UNIT-Electronics-MX/unit_pulsar_rp2350a/tools/product-reference/chapters/08-references.md

## **8 Reference Documentation**

The following resources provide the official hardware, software, and application documentation for the UNIT PULSAR RP2350A.

| Reference | Location |
|---|---|
| Product repository | [UNIT-Electronics-MX/unit_pulsar_rp2350a](https://github.com/UNIT-Electronics-MX/unit_pulsar_rp2350a) |
| Hardware reference | [hardware/README.md](https://github.com/UNIT-Electronics-MX/unit_pulsar_rp2350a/blob/main/hardware/README.md) |
| Technical wiki | [PULSAR RP2350A Wiki](https://github.com/UNIT-Electronics-MX/unit_pulsar_rp2350a/wiki) |
| Getting Started | [Setup guide](https://github.com/UNIT-Electronics-MX/unit_pulsar_rp2350a/wiki/0-Getting-Started) |
| C++ examples | [software/cpp_examples](https://github.com/UNIT-Electronics-MX/unit_pulsar_rp2350a/tree/main/software/cpp_examples) |
| Board schematic | [Hardware V1.3.0 schematic](https://github.com/UNIT-Electronics-MX/unit_pulsar_rp2350a/blob/main/hardware/unit_sch_v_1_3_0_pulsar_rp2350a.pdf) |
| RP2350 component datasheet | [Raspberry Pi RP2350 Datasheet](https://datasheets.raspberrypi.com/rp2350/rp2350-datasheet.pdf) |

The UNIT Electronics Wiki provides application-oriented documentation, setup procedures, peripheral usage examples, and software workflows for the board.

The hardware schematic and this Product Reference define the board-level implementation, connections, power architecture, interfaces, and hardware characteristics. RP2350A device-level electrical characteristics and processor specifications should be referenced from the official Raspberry Pi RP2350 datasheet.
