UNIT-Electronics-MX/unit_pulsar_rp2350a/tools/product-reference/chapters/00-description.md

## **Description**

The UNIT PULSAR RP2350 is a multi-interface development board in the UNIT
DevLab ecosystem, built around the Raspberry Pi RP2350A microcontroller. The V1.3 design
combines external QSPI flash and PSRAM with motion sensing, PDM audio, microSD,
USB-C, battery support, addressable RGB indicators, QWIIC I2C, and a 22-pin
HSTX expansion connector.



### **Applications**

- RP2350 firmware and peripheral prototyping
- Motion and PDM audio acquisition
- microSD data logging
- HSTX graphics experiments
- External-memory and multicore applications
- Education and subsystem validation

### **Hardware Features**

- RP2350A microcontroller with external W25Q128 128 Mbit QSPI flash
- APS6404L-3SQR-ZR 8 MiB PSRAM
- BMI270 six-axis inertial measurement unit
- ICS-41350 digital PDM microphone
- Four-bit SDIO microSD connection
- Three WS2812-compatible RGB LEDs plus power, charge, and user indicators
- USB-C, QWIIC, battery, edge-pad, SWD, and HSTX connections
