UNIT-Electronics-MX/unit_pulsar_rp2350a/tools/product-reference/chapters/01-board.md

## **1 The Board**

The UNIT PULSAR RP2350 is a development board for evaluating the
Raspberry Pi RP2350A and building applications that combine high-speed digital
output, removable storage, motion sensing, digital audio, external memory, and
general-purpose I/O. Hardware revision V1.3.0 places the controller, QSPI flash,
PSRAM, power components, indicators, and user controls on the top side. The
microSD socket, battery connection, onboard microphone, debug pads, and HSTX
connector are accessible from the bottom side.

### **1.1 Accessories** {.section-page}

The following optional accessories are recommended for use with the UNIT PULSAR RP2350A. Select accessories according to the interfaces and features required by the application.

| Accessory | Purpose | Selection notes |
|---|---|---|
| [QWIIC cable](https://uelectronics.com/producto/arnes-qwiic-4-pines-pitch-1mm/) | External I2C expansion | 4-pin, 1 mm pitch cable for connecting compatible 3.3 V QWIIC devices |
| USB-C data cable | Power, programming, and USB serial | Must support data; a charge-only cable cannot upload firmware |
| [MicroSD card](https://uelectronics.com/producto/memoria-micro-sd-kingston-16-64-gb-clase-10/) | Removable storage and data logging | Class 10 microSD card; FAT32 formatting is recommended for the provided examples |
| [UNIT DevLab DVI to FPC Adapter](https://uelectronics.com/producto/adaptador-dvi-a-fpc-unit-devlab/) | HSTX DVI-compatible video output | Recommended adapter for using the board's HSTX video interface through the 22-pin FPC connector |
| 22-pin FPC cable | Connection between the HSTX connector and DVI adapter | 22-position, 0.5 mm pitch; planned for future availability from UNIT Electronics |
| [LiPo 3.7 V 650 mAh Battery](https://uelectronics.com/producto/bateria-lipo-3-7v-650mah-802535/) | Battery-powered operation | Recommended single-cell LiPo battery; verify polarity and connector orientation before connection |

Verify connector type, orientation, polarity, voltage domain, and pinout before connecting accessories.

### **1.2 Board Identification**

| Item | Value |
|---|---|
| Product | UNIT PULSAR RP2350 |
| Product family | UNIT DevLab ecosystem |
| Product type | Multi-interface RP2350A development board |
| Main component | Raspberry Pi RP2350A, QFN-60 |
| Hardware revision | V1.3.0 |
| Product Reference | Version 0.1.0 |
| Primary programming interface | USB-C / RP2350 USB boot workflow |
| Debug interface | SWD pads on bottom side |

Hardware revision and documentation revision are identified independently.

### **1.3 Main Assemblies**

| RefDes | Component | Function |
|---|---|---|
| IC3 | RP2350A | Main processor and peripheral controller |
| IC1 | W25Q128JVPIQ | 128 Mbit (16 MiB) external QSPI flash |
| IC4 | APS6404L-3SQR-ZR | 8 MiB external PSRAM |
| IC5 | BMI270 | Six-axis accelerometer and gyroscope |
| MK1 | ICS-41350 | Digital PDM microphone |
| U1 | AP2112K-3.3TRG1 | Fixed 3.3 V LDO |
| IC2 | MCP73831T-2ACI/OT | Single-cell Li-Ion/Li-Polymer charge controller |
| XTAL1 | XOS20012000LT00351005 | 12 MHz reference oscillator |
| MICRO_SD-HOLDER | 47309-2651 | Removable microSD storage |
| LED1–LED3 | WS2812 1010 | Cascaded addressable RGB indicators |
| J1 | HCZZ0032-4 | Four-position QWIIC-style I2C connector |
| J5 | FH34SRJ-22S-0.5SH(50) | 22-position HSTX FFC/FPC connector |
| JP1 | PH2.0 2P | Two-position battery connection |

### **1.4 Board Views** {.section-page}



The top view identifies the USB-C connector, BOOT and reset controls, edge-pad
labels, RP2350A, flash, PSRAM, QWIIC connector, oscillator, and three RGB LEDs.



The bottom view identifies the battery polarity marks, microSD socket, microphone acoustic port, SWD pads, HSTX connector, and V1.3.0 revision marking.

### **1.5 Handling** {.section-page}

Handle the board using normal ESD precautions. Avoid touching the microphone
port, connector contacts, or exposed test pads. Remove power before inserting
or removing FFC/FPC and battery connectors. Keep conductive objects away from
the bottom-side battery and microSD areas when the board is energized.
