UNIT-Electronics-MX/unit_pulsar_rp2350a/docs/hardware/index.html

UNIT Electronics · DevLab

# UNIT PULSAR RP2350 SENSE

Direct links to hardware documentation and product files for use in external platforms.

42 files 31 images 6 formats 57.2 MB total

Search hardware resources

## Product documents

6 files

DOCX 3.6 MB

### Product Reference

Editable product reference

unit_product_reference_v_0_1_0_pulsar_rp2350a.docx

Copy link Open file

PDF 3.9 MB

### Product Reference

Publication-ready product reference

unit_product_reference_v_0_1_0_pulsar_rp2350a.pdf

Copy link Open file

PDF 248.5 KB

### Schematic

Electrical schematic

unit_sch_v_1_3_0_pulsar_rp2350a.pdf

Copy link Open file

PNG 536.8 KB

### Schematic

Electrical schematic

resources/unit_schematic_v_1_3_0_pulsar_rp2350a_sheet_1.png

Copy link Open file

PNG 176.1 KB

### Schematic

Electrical schematic

resources/unit_schematic_v_1_3_0_pulsar_rp2350a_sheet_2.png

Copy link Open file

PNG 84.6 KB

### Schematic

Electrical schematic

resources/unit_schematic_v_1_3_0_pulsar_rp2350a_sheet_3.png

Copy link Open file

## Pinouts

12 files

PDF 1.5 MB

### Pinout — English

Connector and signal reference in English

unit_bottom_pinout_v1_3_0_ue0103_pulsar_rp2350a_en.pdf

Copy link Open file

PDF 3.2 MB

### Pinout — English

Connector and signal reference in English

unit_pinout_v1_3_0_ue0103_pulsar_rp2350a_en.pdf

Copy link Open file

PDF 1.9 MB

### Pinout — English

Connector and signal reference in English

unit_top_pinout_v1_3_0_ue0103_pulsar_rp2350a_en.pdf

Copy link Open file

PNG 1.8 MB

### Pinout — English

Connector and signal reference in English

resources/unit_bottom_pinout_v1_3_0_ue0103_pulsar_rp2350a_en.png

Copy link Open file

PNG 3.8 MB

### Pinout — English

Connector and signal reference in English

resources/unit_pinout_v1_3_0_ue0103_pulsar_rp2350a_en.png

Copy link Open file

PNG 2.2 MB

### Pinout — English

Connector and signal reference in English

resources/unit_top_pinout_v1_3_0_ue0103_pulsar_rp2350a_en.png

Copy link Open file

PDF 1.5 MB

### Pinout — Spanish

Connector and signal reference in Spanish

unit_bottom_pinout_v1_3_0_ue0103_pulsar_rp2350a_es.pdf

Copy link Open file

PDF 3.2 MB

### Pinout — Spanish

Connector and signal reference in Spanish

unit_pinout_v1_3_0_ue0103_pulsar_rp2350a_es.pdf

Copy link Open file

PDF 1.9 MB

### Pinout — Spanish

Connector and signal reference in Spanish

unit_top_pinout_v1_3_0_ue0103_pulsar_rp2350a_es.pdf

Copy link Open file

PNG 1.8 MB

### Pinout — Spanish

Connector and signal reference in Spanish

resources/unit_bottom_pinout_v1_3_0_ue0103_pulsar_rp2350a_es.png

Copy link Open file

PNG 3.8 MB

### Pinout — Spanish

Connector and signal reference in Spanish

resources/unit_pinout_v1_3_0_ue0103_pulsar_rp2350a_es.png

Copy link Open file

PNG 2.2 MB

### Pinout — Spanish

Connector and signal reference in Spanish

resources/unit_top_pinout_v1_3_0_ue0103_pulsar_rp2350a_es.png

Copy link Open file

## Board views

5 files

JPG 4.5 MB

### Board Topology

Functional board layout

resources/unit_topology_v1_3_0_ue0103_pulsar_rp2350a.jpg

Copy link Open file

PNG 2.7 MB

### Board Topology

Functional board layout

resources/unit_topology_v1_3_0_ue0103_pulsar_rp2350a.png

Copy link Open file

PNG 85.9 KB

### Bottom View

Bottom-side board view

resources/unit_btm_v_1_3_0_pulsar_rp2350a.png

Copy link Open file

PNG 1.9 MB

### Mechanical Dimensions

Board outline and dimensions

resources/unit_dimensions_v1_3_0_ue0103_pulsar_rp2350a.png

Copy link Open file

PNG 111.8 KB

### Top View

Top-side board view

resources/unit_top_v_1_3_0_pulsar_rp2350a.png

Copy link Open file

## Other resources

19 files

MD 7.2 KB

### Hardware README

Hardware overview and source notes

README.md

Copy link Open file

PDF 7.6 MB

### Rp2350 Datasheet

Hardware resource

rp2350-datasheet.pdf

Copy link Open file

PNG 251.0 KB

### Unit Block Diagram V 1 3 0 Pulsar Rp2350A

Hardware resource

resources/unit_block_diagram_v_1_3_0_pulsar_rp2350a.png

Copy link Open file

SVG 3.7 KB

### Unit Block Diagram V 1 3 0 Pulsar Rp2350A

Hardware resource

resources/unit_block_diagram_v_1_3_0_pulsar_rp2350a.svg

Copy link Open file

JPG 385.4 KB

### Unit Block V 1 0 0 Ue0103 Pulsar Rp2350A

Hardware resource

resources/unit_block_v_1_0_0_ue0103_pulsar_rp2350a.jpg

Copy link Open file

JPG 255.1 KB

### Unit Power Tree V 1 0 0 Ue0103 Pulsar Rp2350A

Hardware resource

resources/unit_power_tree_v_1_0_0_ue0103_pulsar_rp2350a.jpg

Copy link Open file

PNG 189.4 KB

### Unit Power Tree V 1 3 0 Pulsar Rp2350A

Hardware resource

resources/unit_power_tree_v_1_3_0_pulsar_rp2350a.png

Copy link Open file

SVG 3.0 KB

### Unit Power Tree V 1 3 0 Pulsar Rp2350A

Hardware resource

resources/unit_power_tree_v_1_3_0_pulsar_rp2350a.svg

Copy link Open file

JPG 91.8 KB

### Unit Rp2350A Qfn60 Package Pulsar Rp2350

Hardware resource

resources/unit_rp2350a_qfn60_package_pulsar_rp2350.jpg

Copy link Open file

JPG 146.2 KB

### Unit Wiki Battery Rp2350

Hardware resource

resources/unit_wiki_battery_rp2350.jpg

Copy link Open file

PNG 257.2 KB

### Unit Wiki Hstx Pulsar Rp2350

Hardware resource

resources/unit_wiki_hstx_pulsar_rp2350.png

Copy link Open file

PNG 191.5 KB

### Unit Wiki I2C Pulsar Rp2350

Hardware resource

resources/unit_wiki_i2c_pulsar_rp2350.png

Copy link Open file

PNG 154.1 KB

### Unit Wiki Led Builtin Pulsar Rp2350

Hardware resource

resources/unit_wiki_led_builtin_pulsar_rp2350.png

Copy link Open file

PNG 138.2 KB

### Unit Wiki Microsd Pulsar Rp2350

Hardware resource

resources/unit_wiki_microsd_pulsar_rp2350.png

Copy link Open file

PNG 159.3 KB

### Unit Wiki Pdm Pulsar Rp2350

Hardware resource

resources/unit_wiki_pdm_pulsar_rp2350.png

Copy link Open file

PNG 153.7 KB

### Unit Wiki Psram Pulsar Rp2350

Hardware resource

resources/unit_wiki_psram_pulsar_rp2350.png

Copy link Open file

PNG 33.1 KB

### Unit Wiki Udvi Library Pulsar Rp2350

Hardware resource

resources/unit_wiki_udvi_library_pulsar_rp2350.png

Copy link Open file

JPG 158.2 KB

### Unit Wiki Usb Rp2350

Hardware resource

resources/unit_wiki_usb_rp2350.jpg

Copy link Open file

PNG 281.2 KB

### Unit Wiki Ws2812 Pulsar Rp2350

Hardware resource

resources/unit_wiki_ws2812_pulsar_rp2350.png

Copy link Open file

No resources match your search.

UNIT Electronics hardware resources
