UNIT-Electronics-MX/unit_pulsar_rp2350a/docs/hardware/resources/unit_block_diagram_v_1_3_0_pulsar_rp2350a.png

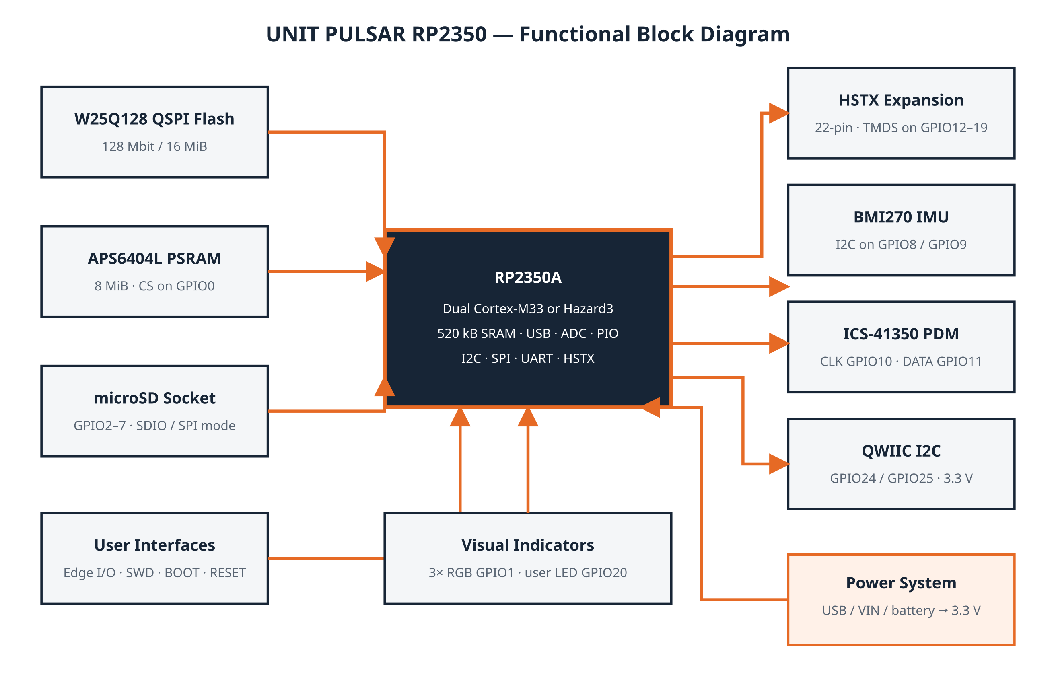
docs/hardware/resources/unit_block_diagram_v_1_3_0_pulsar_rp2350a.png
