UNIT-Electronics-MX/unit_pulsar_rp2350a/docs/hardware/resources/unit_bottom_pinout_v1_3_0_ue0103_pulsar_rp2350a_en.png

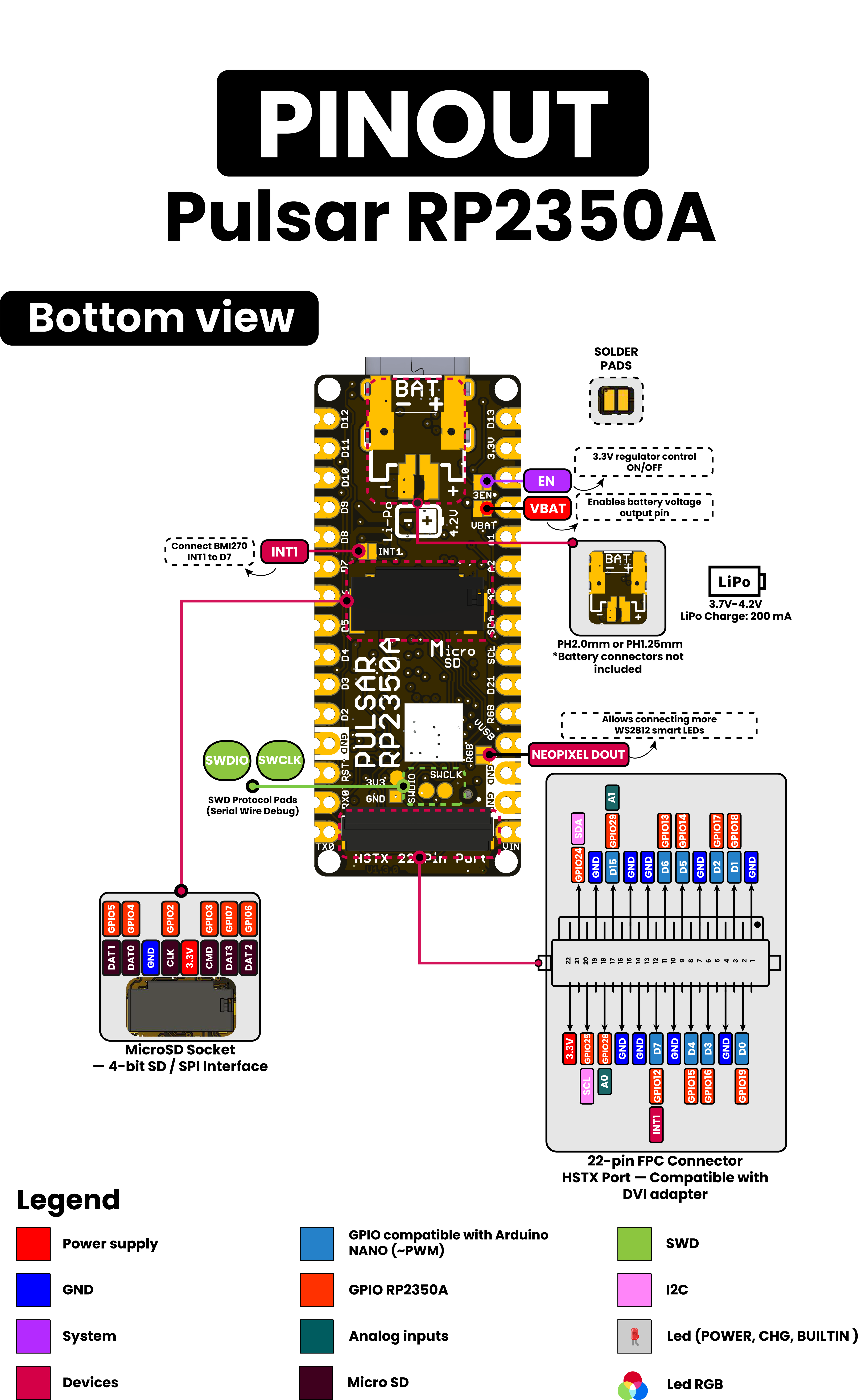
docs/hardware/resources/unit_bottom_pinout_v1_3_0_ue0103_pulsar_rp2350a_en.png
