UNIT-Electronics-MX/unit_pulsar_rp2350a/docs/hardware/resources/unit_power_tree_v_1_3_0_pulsar_rp2350a.png

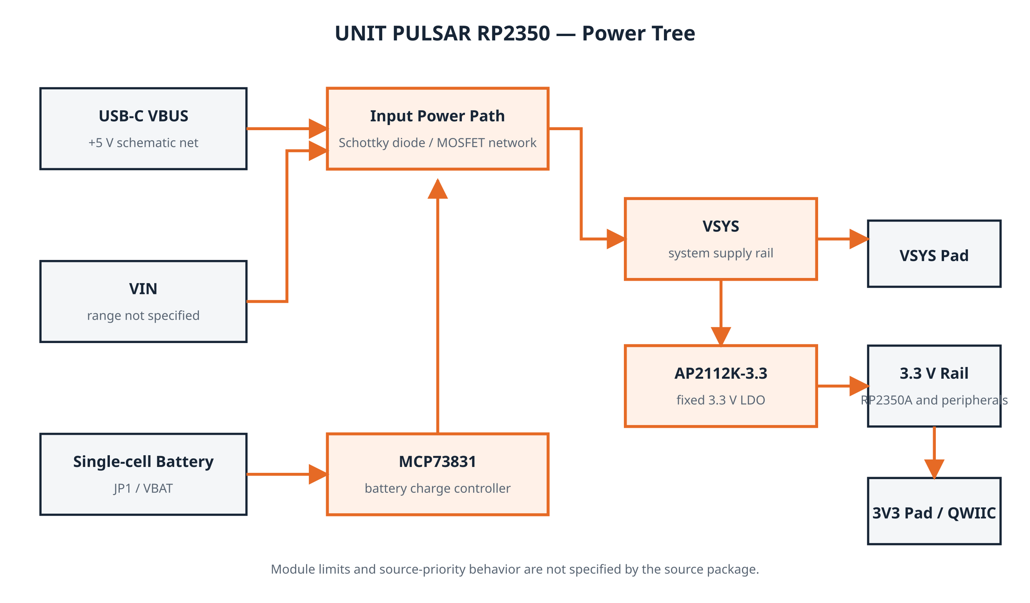
docs/hardware/resources/unit_power_tree_v_1_3_0_pulsar_rp2350a.png
