UNIT-Electronics-MX/unit_pulsar_rp2350a/docs/hardware/resources/unit_wiki_usb_rp2350.jpg

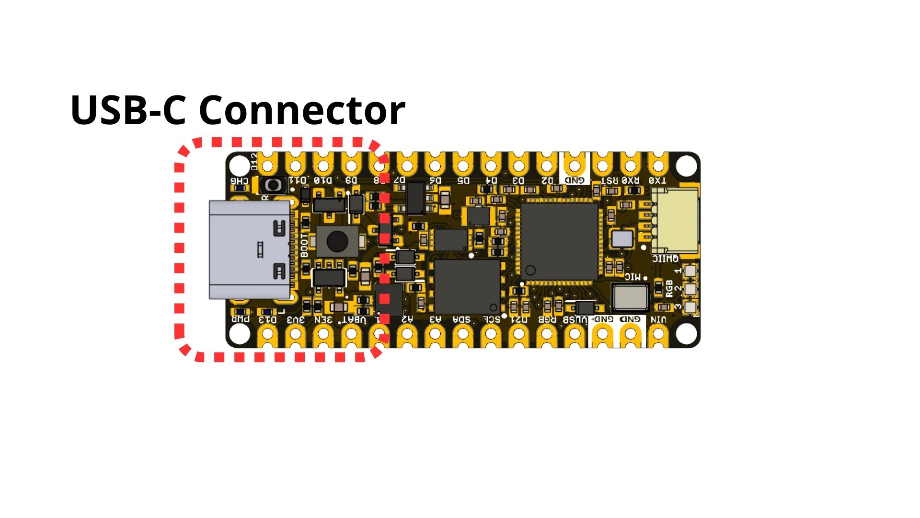
docs/hardware/resources/unit_wiki_usb_rp2350.jpg
