UNIT-Electronics-MX/unit_pulsar_rp2350a/tools/product-reference/assets/arduino_rp2350.png

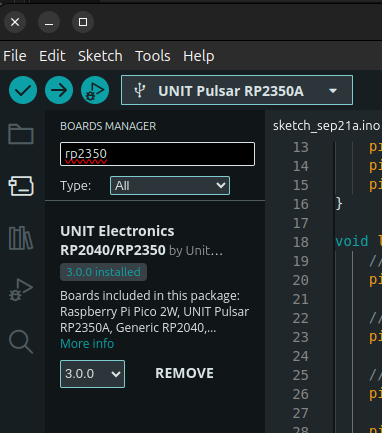
tools/product-reference/assets/arduino_rp2350.png
