UNIT-Electronics-MX/unit_pulsar_rp2350a/docs/hardware/unit_bottom_pinout_v1_3_0_ue0103_pulsar_rp2350a_en.pdf

# PINOUT

# Pulsar RP2350A

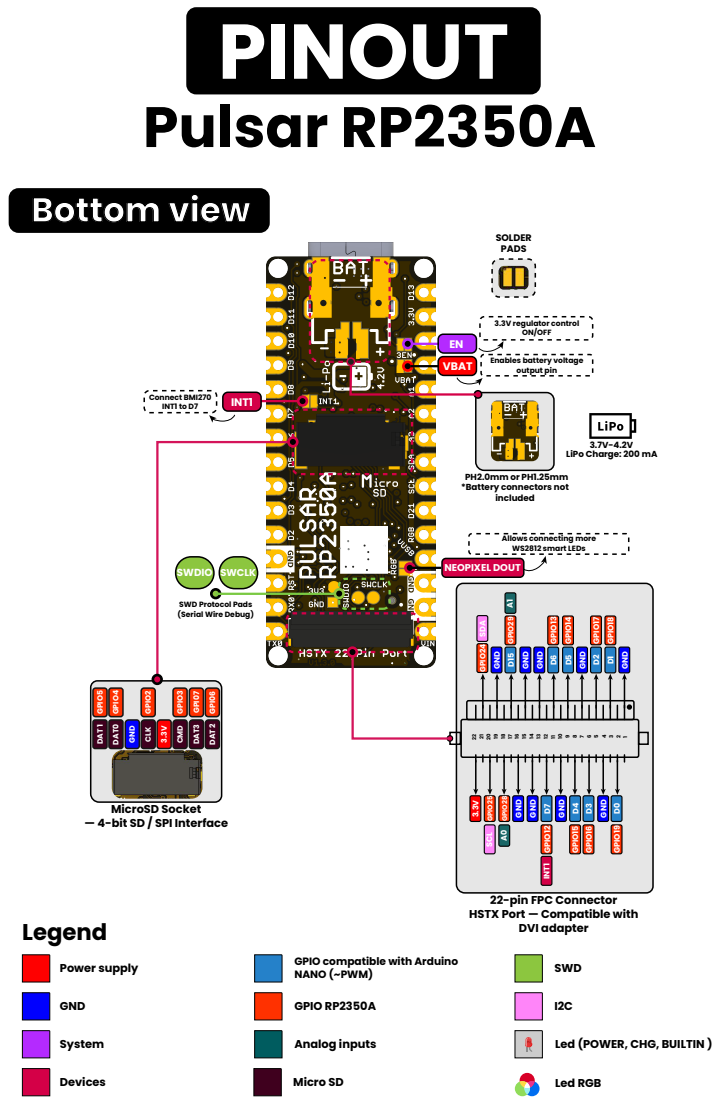
[picture p25: page 1]

MicroSD Socket
— 4-bit SD / SPI Interface

22-pin FPC Connector
HSTX Port — Compatible with
DVI adapter

Led (POWER, CHG, BUILTIN )
