UNIT-Electronics-MX/unit_pulsar_rp2350a/docs/hardware/unit_bottom_pinout_v1_3_0_ue0103_pulsar_rp2350a_es.pdf

# PINOUT

# Pulsar RP2350A

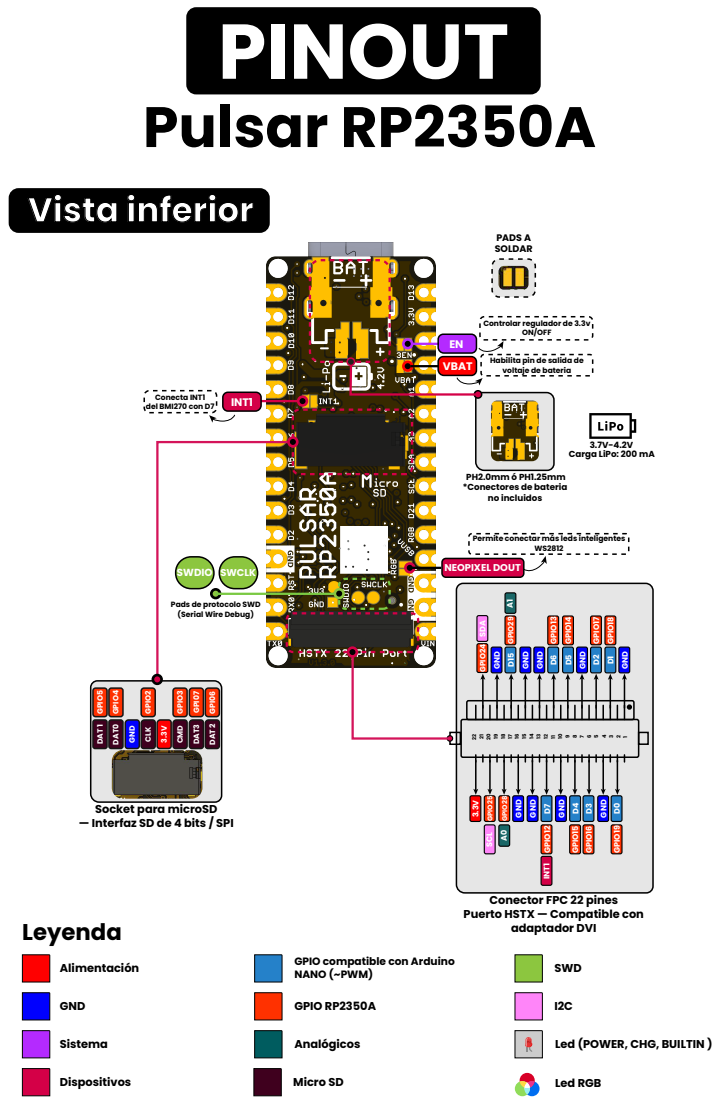
[picture p26: page 1]

Habilita pin de salida de
voltaje de bateria

Permite conectar más leds inteligentes

Pads de protocolo SWD
(Serial Wire Debug)

Socket para microSD
— Interfaz SD de 4 bits / SPI

Conector FPC 22 pines
Puerto HSTX — Compatible con
adaptador DVI

Led (POWER, CHG, BUILTIN )
