UNIT-Electronics-MX/unit_pulsar_rp2350a/docs/hardware/unit_pinout_v1_3_0_ue0103_pulsar_rp2350a_en.pdf

Top view | Bottom view

# PINOUT

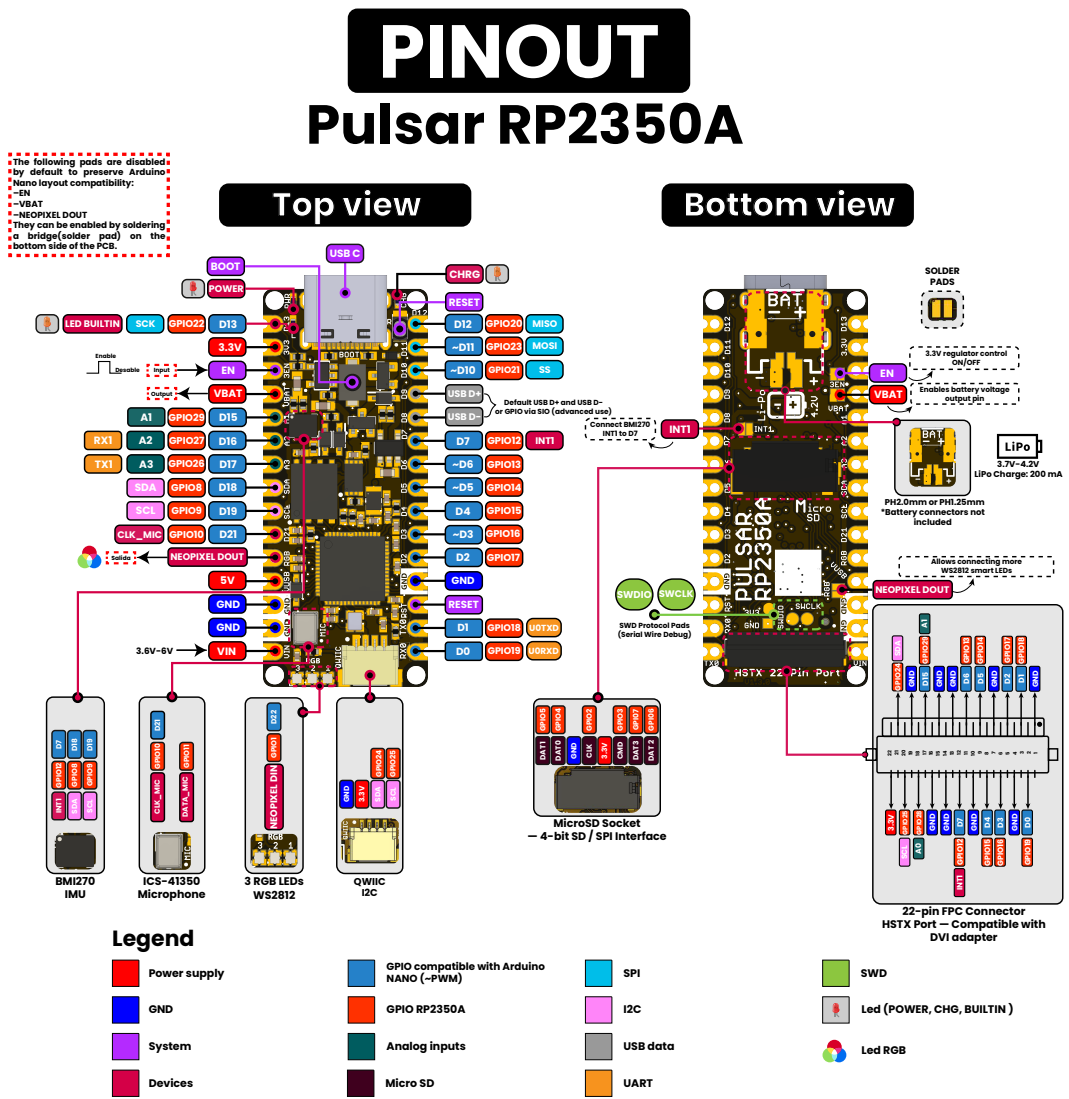
[picture p27: page 1]

The following pads are disabled
by default to preserve Arduino
Nano layout compatibility:
–VBAT
–NEOPIXEL DOUT
They can be enabled by soldering
a bridge(solder pad) on the
bottom side of the PCB.

Default USB D+ and USB D-
or GPIO via SIO (advanced use)

MicroSD Socket
— 4-bit SD / SPI Interface

22-pin FPC Connector
HSTX Port — Compatible with
DVI adapter

Led (POWER, CHG, BUILTIN )
