UNIT-Electronics-MX/unit_pulsar_rp2350a/docs/hardware/unit_pinout_v1_3_0_ue0103_pulsar_rp2350a_es.pdf

Vista superior | Vista inferior

# PINOUT

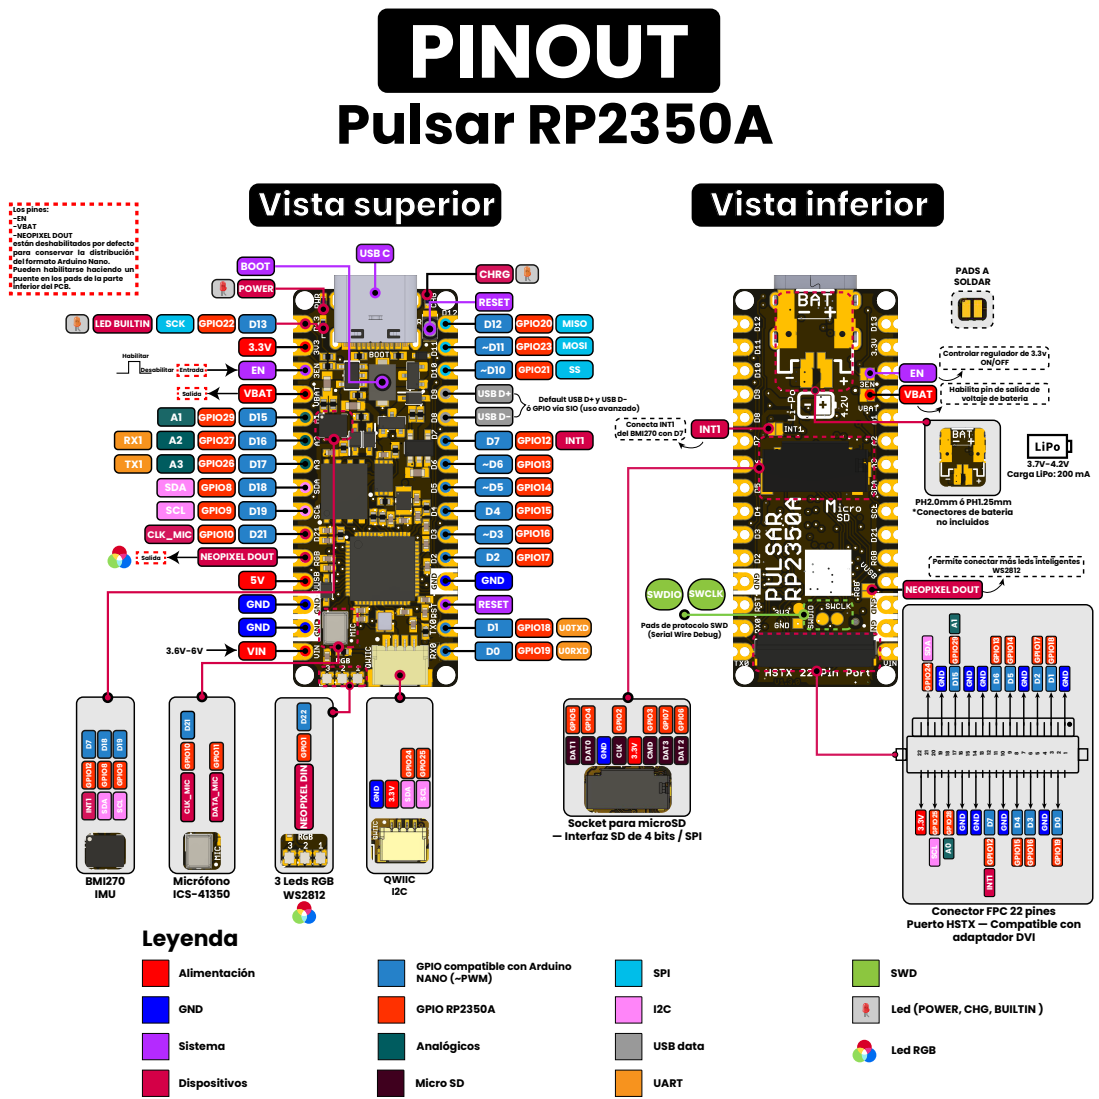
[picture p28: page 1]

Los pines:
-VBAT
-NEOPIXEL DOUT
están deshabilitados por defecto
para conservar la distribución
del formato Arduino Nano.
Pueden habilitarse haciendo un
puente en los pads de la parte
inferior del PCB.

Habilita pin de salida de
voltaje de bateria

Default USB D+ y USB D-
ó GPIO vía SIO (uso avanzado)

Permite conectar más leds inteligentes
NEOPIXEL DOUT

Pads de protocolo SWD
(Serial Wire Debug)

Socket para microSD
— Interfaz SD de 4 bits / SPI

Conector FPC 22 pines
Puerto HSTX — Compatible con
adaptador DVI

Led (POWER, CHG, BUILTIN )
