UNIT-Electronics-MX/unit_pulsar_rp2350a/docs/hardware/unit_top_pinout_v1_3_0_ue0103_pulsar_rp2350a_en.pdf

# Top view

# PINOUT

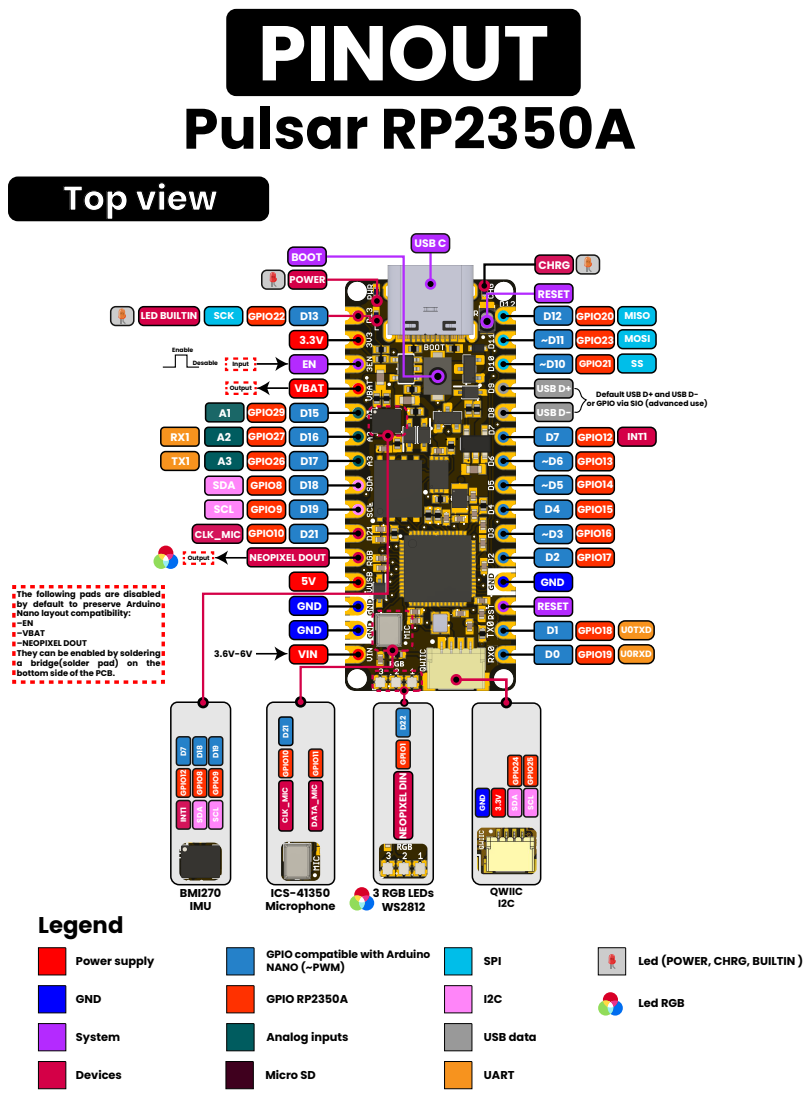
[picture p29: page 1]

Default USB D+ and USB D-
or GPIO via SIO (advanced use)

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

Led (POWER, CHRG, BUILTIN )
