UNIT-Electronics-MX/unit_pulsar_rp2350a/docs/hardware/unit_top_pinout_v1_3_0_ue0103_pulsar_rp2350a_es.pdf

# Vista superior

# PINOUT

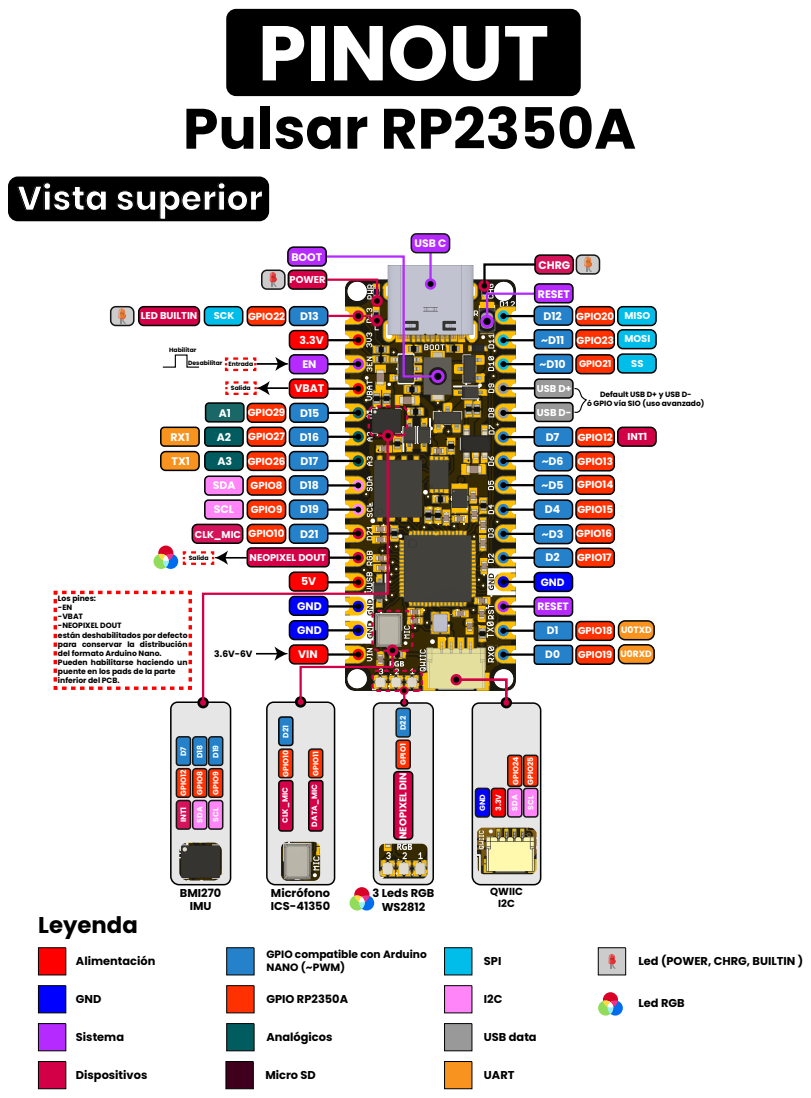
[picture p30: page 1]

Default USB D+ y USB D-
ó GPIO vía SIO (uso avanzado)

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

Led (POWER, CHRG, BUILTIN )
