UNIT-Electronics-MX/unit_pulsar_rp2350a/hardware/unit_sch_v_1_3_0_pulsar_rp2350a.pdf

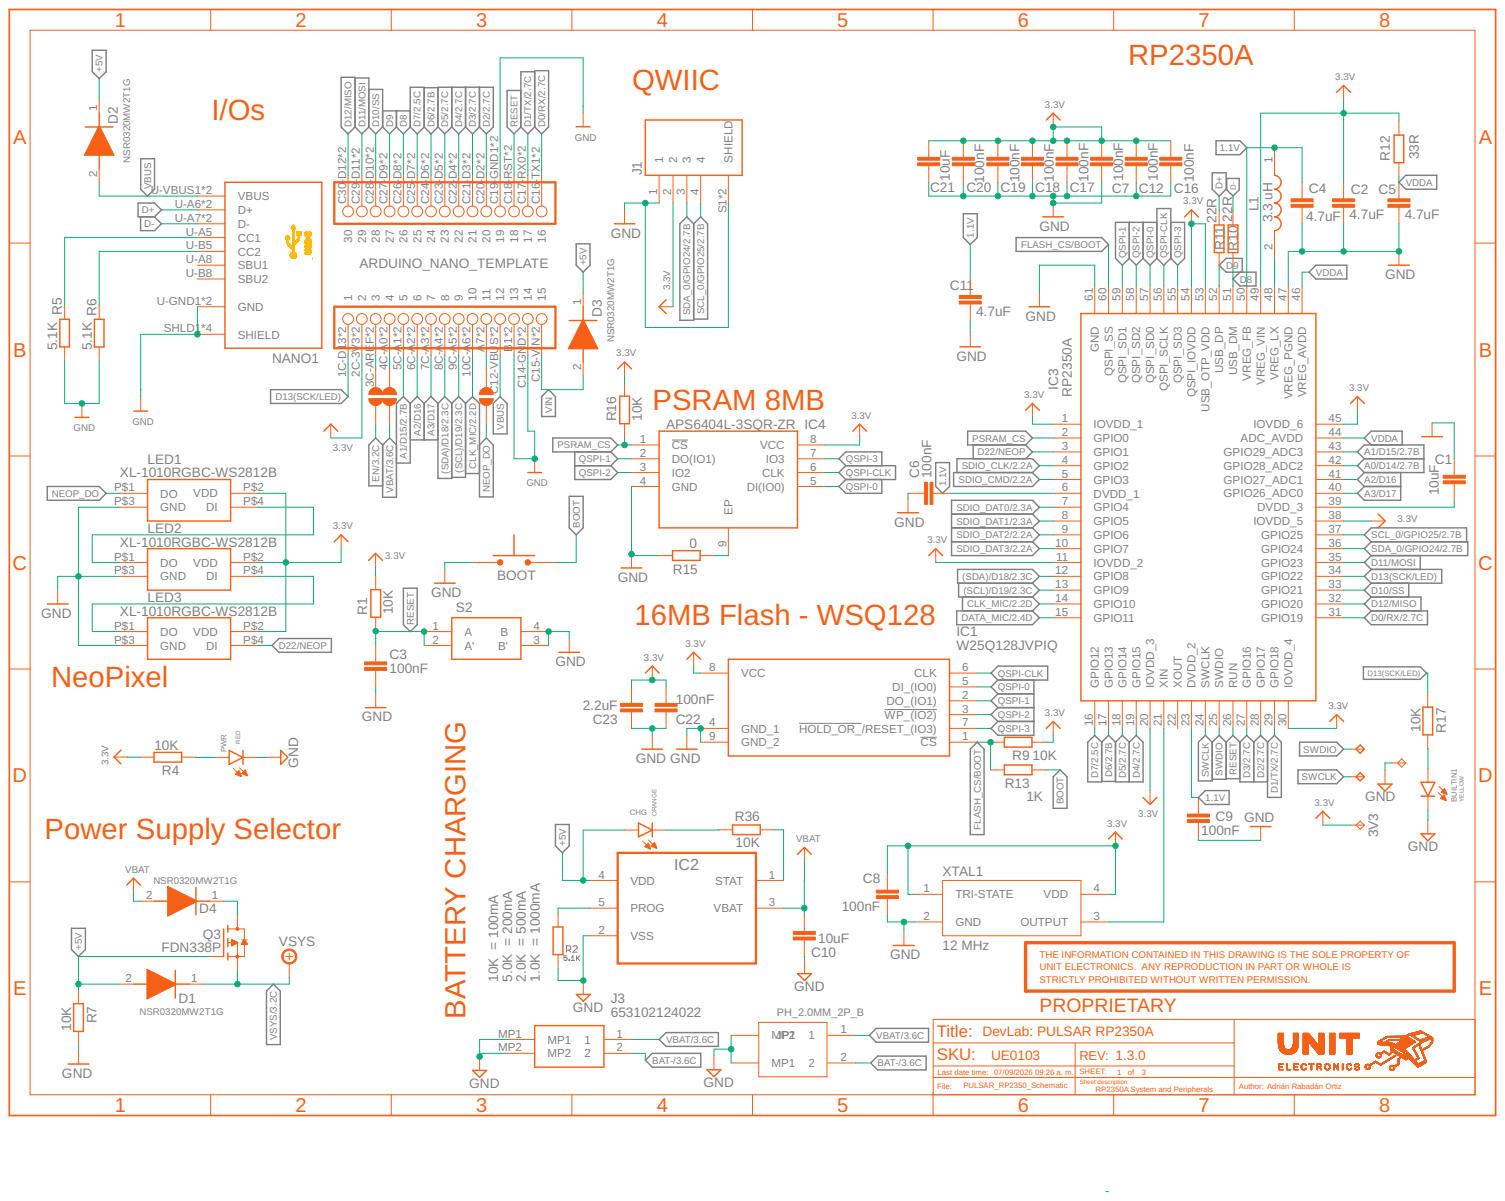
[picture p31: page 1]

THE INFORMATION CONTAINED IN THIS DRAWING IS THE SOLE PROPERTY OF UNIT ELECTRONICS. ANY REPRODUCTION IN PART OR WHOLE IS

STRICTLY PROHIBITED WITHOUT WRITTEN PERMISSION. PROPRIETARY

DevLab: PULSAR RP2350A | Author:
SKU: Last date time: UE0103 | REV: SHEET: Sheet description: 1.3.0 of File:

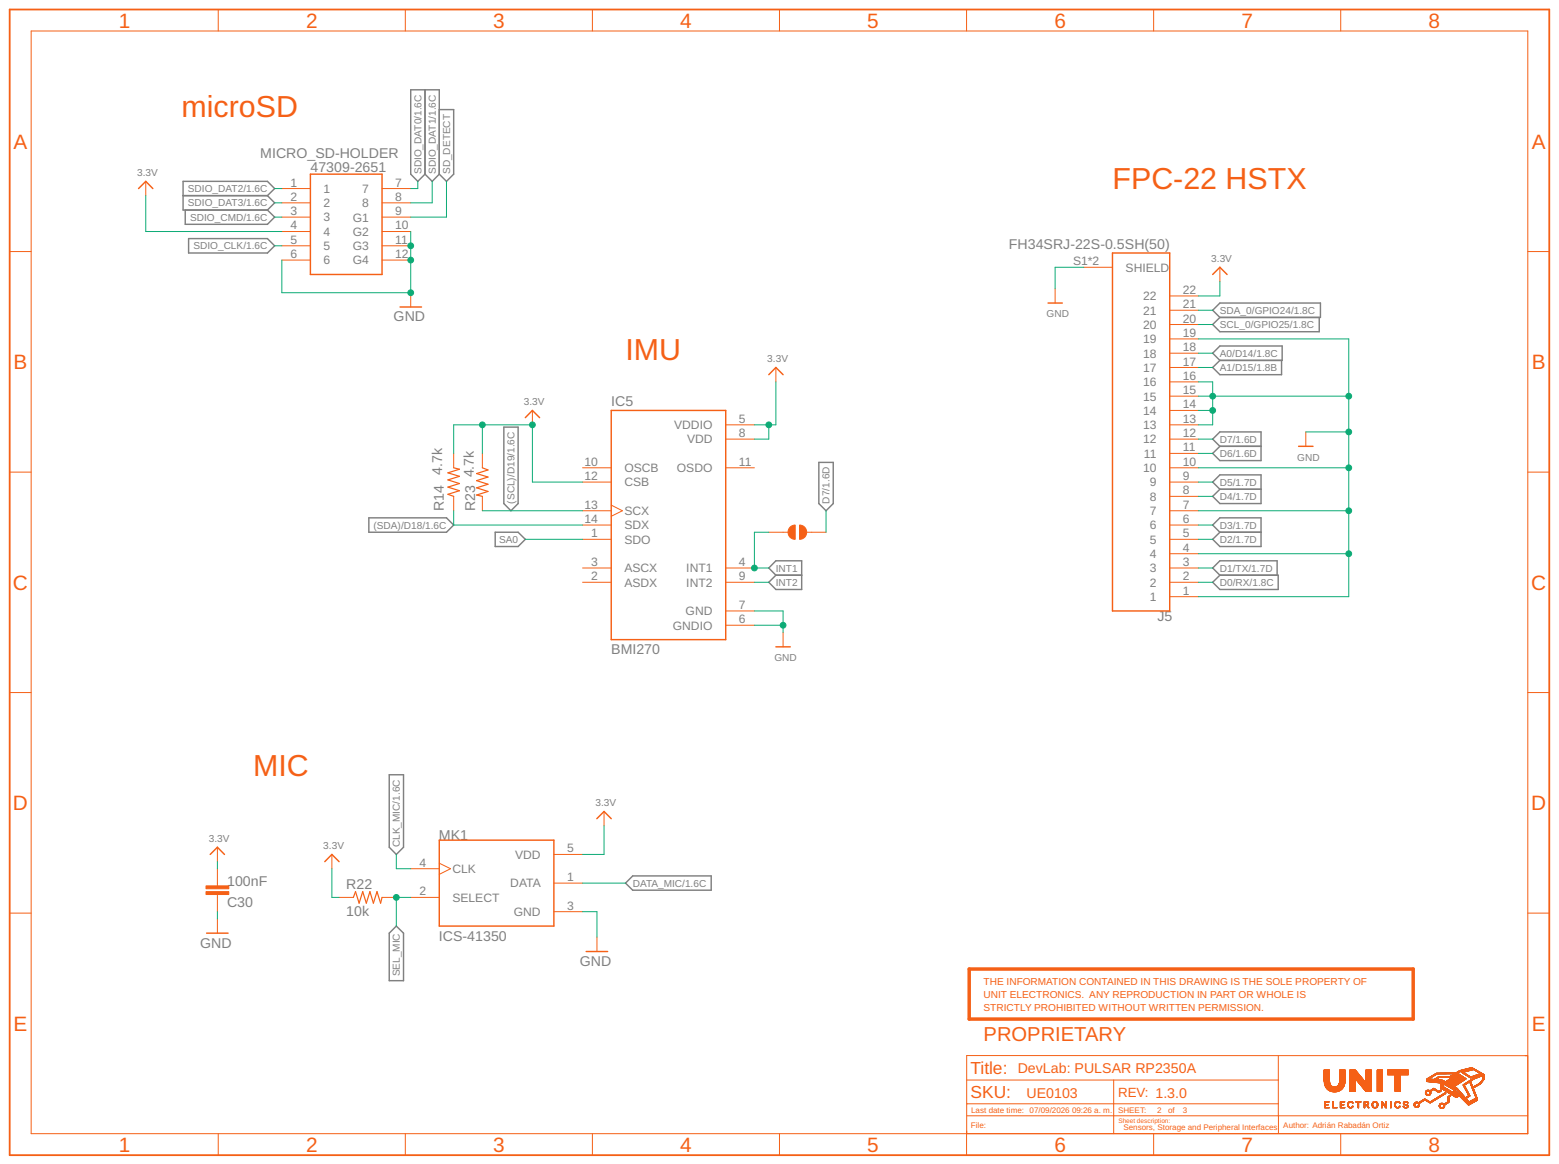
[picture p32: page 2]

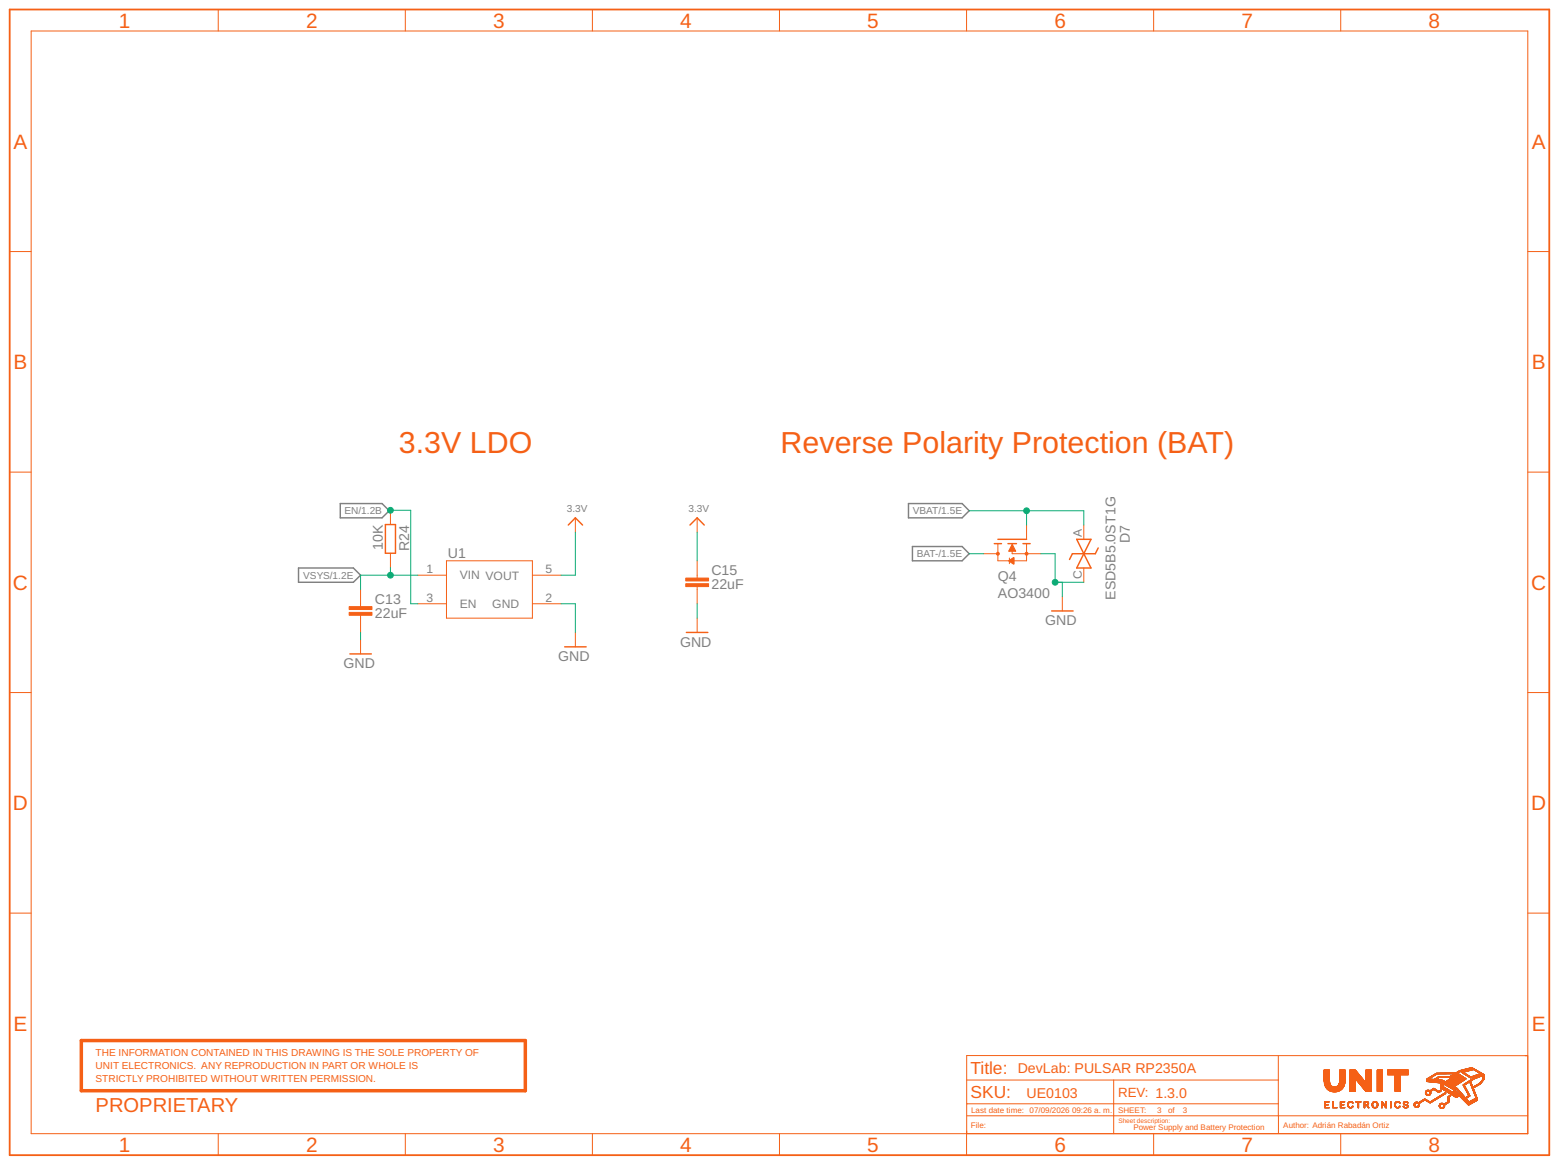
[picture p33: page 3]
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
