UNIT-Electronics-MX/unit_pulsar_rp2350a/software/cpp_examples/03_ws2812/brightness_control/brightness_control.ino

// Source: PULSAR RP2350 technical wiki, 3-WS2812B-Implementation.md

#include <Adafruit_NeoPixel.h>

#define WS_PIN 1
#define LED_COUNT 3

Adafruit_NeoPixel pixels(LED_COUNT, WS_PIN, NEO_GRB + NEO_KHZ800);

void setup() {
  pixels.begin();
  pixels.setBrightness(32);
}

void loop() {
  for (int i = 0; i < 255; i += 5) {
    for (int pixel = 0; pixel < LED_COUNT; pixel++) {
      pixels.setPixelColor(pixel, pixels.Color(i, 0, 255 - i));
    }
    pixels.show();
    delay(20);
  }
}
