UNIT-Electronics-MX/unit_pulsar_rp2350a/(commit log)

2026-08-03 docs(hardware): add hardware documentation and schematic
2026-08-03 docs(hardware): add block diagram, power tree, and schematic images
2026-08-03 docs(hardware): update board diagrams and hardware documentation
2026-08-03 docs(examples): refresh Arduino example sketches
2026-08-27 docs(README): Power tree & block diagram added v1.0.0
2026-08-27 docs(README): Power tree & block diagram corresponding to board verion 1.3.0 added in README
2026-08-27 docs(README): Power tree & block diagram V1.0.0 added to hardware read from 1.3.0 PULSAR BORAD 2nd try
2026-08-27 docs(README): Power tree & block diagram V1.0.0 added to hardware read from 1.3.0 PULSAR BORAD 3rd try. Sorry guys I,m still learning this stuff
2026-09-04 Fix GPIO pin assignment for D13
    Corrected GPIO pin assignment for D13 from GPIO20 to GPIO22.
2026-09-07 docs: update the schematics file to v1.3
2026-09-21 docs: correct microphone port description in Section 1.4 Board Views
2026-09-21 docs: update Sections 2.1 and 2.2 with final power ratings and operating conditions
2026-09-21 docs: revise Sections 2.5 and 2.6 board characteristics and electrical precautions
2026-09-21 docs: add topology image in 3.2 Board Topology section
2026-09-21 docs: update topology table with INT and RGB solder jumper functions
2026-09-21 docs: update Sections 3.6-3.10 with final peripheral and power configuration
2026-09-21 docs: update Chapter 4 pinouts, solder jumpers, power connections, and HSTX mapping
